Vassar-Robot-Competition-2018/teamD/Photos_Videos/Robot V1.jpg

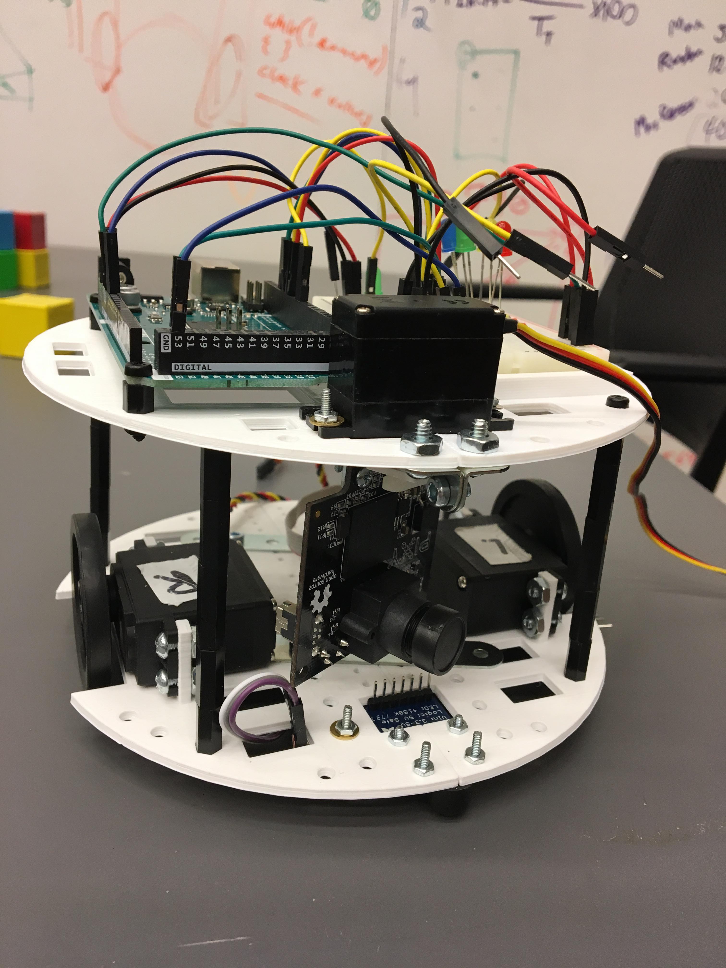
Photos_Videos/Robot V1.jpg
