Vassar-Robot-Competition-2018/teamD/Photos_Videos/Robot V2.jpg

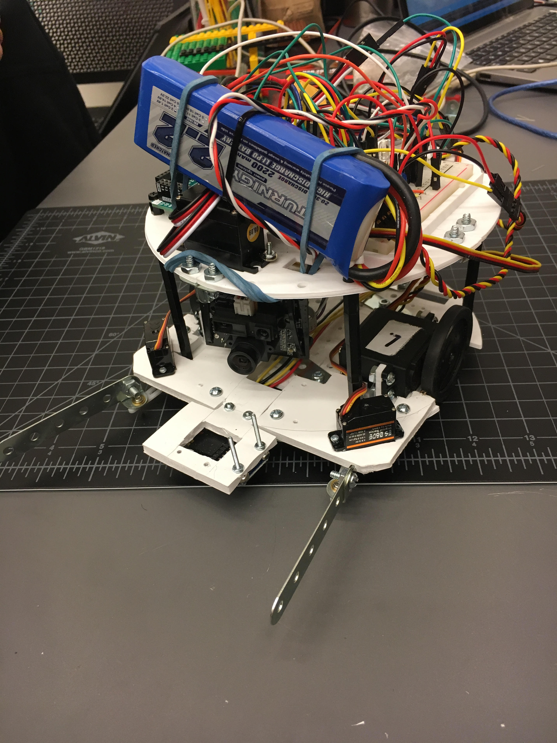
Photos_Videos/Robot V2.jpg
