Vassar-Robot-Competition-2018/teamD/Photos_Videos/Robot V4.JPG

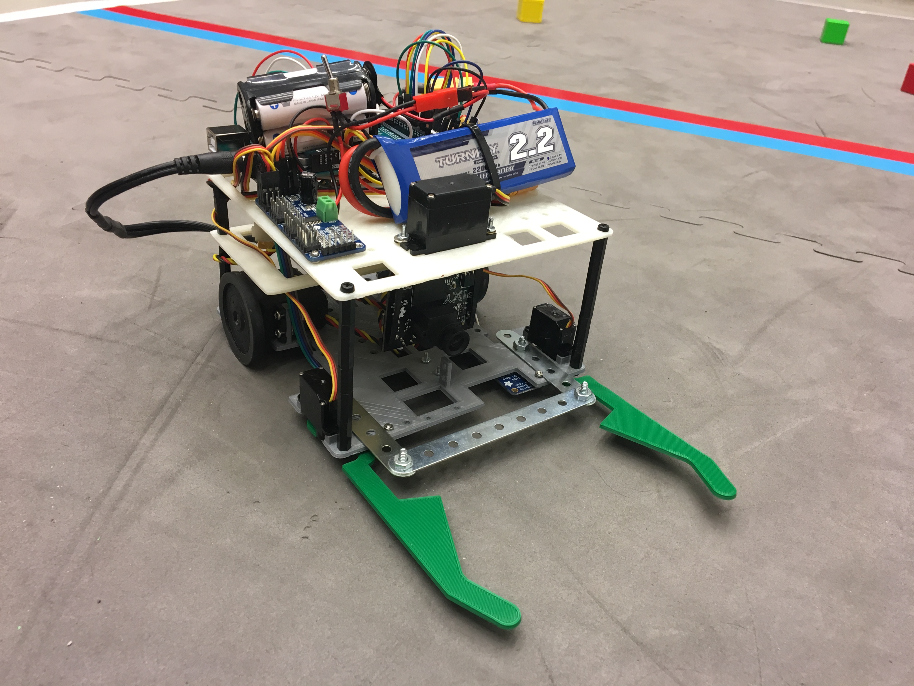
Photos_Videos/Robot V4.JPG
