Vassar-Robot-Competition-2018/teamD/Code/Final Code/Competition_Code/Competition_Code.ino

#include <SPI.h>
#include <Pixy.h>
#include <Wire.h>
#include <SoftwareWire.h>
#include <Adafruit_PWMServoDriver.h>
#include "Adafruit_TCS34725softi2c.h"
#include <Adafruit_VL6180X.h>

Pixy pixy;                // main Pixy object

#define WHITE  33         // white LED
#define RED_F 23          // right red LED 
#define YELLOW_F  27      // right yellow LED
#define GREEN_F  25       // right green LED
#define BLUE_F  29        // right blue LED
#define RED_B  37         // left red LED
#define YELLOW_B  41      // left yellow LED
#define GREEN_B  39       // left green LED
#define BLUE_B  43        // left blue LED
#define SDApinL  3        // SDA for left color sensor
#define SCLpinL  2        // SCL for left color sensor
#define SDApinR  5        // SDA for right color sensor
#define SCLpinR  4        // SCL for right color sensor
#define L_ARM  0          // left arm servo
#define R_ARM  1          // right arm servo
#define PAN_SERVO  2      // camera panning servo
#define L_WHEEL  4        // left wheel servo
#define R_WHEEL  5        // right wheel servo
#define PAN_MIN  240      // 250 (-100 mapped) far LEFT; 350 (0 mapped) is STRAIGHT FWD
#define PAN_MAX  455      // 450 (100 mapped) far RIGHT 
#define L_ARM_MIN  410    // 350 is OPEN (0 mapped)
#define L_ARM_MAX  435    // 375 is CLOSED (100 mapped)
#define R_ARM_MIN  320    // 328 is CLOSED (100 mapped)
#define R_ARM_MAX  350    // 355 is OPEN (0 mapped)
#define L_WHEEL_MIN  220  // 238 (100 mapped) full FORWARD; 360 is STOPPED (0 mapped)
#define L_WHEEL_MAX  500  // 482 (-100 mapped) full REVERSE;
#define R_WHEEL_MIN  220  // 238 (-100 mapped) full REVERSE; 360 is STOPPED (0 mapped)  230
#define R_WHEEL_MAX  500  // 482 (100 mapped) full FORWARD,                             490


//Declares constants

const int camSP = 160,     // pixy cam setpoint for pan PID
          servoSP = 0,
          camInterval = 20,
          wheelInterval = 20,
          scanInterval = 20,
          blockInterval = 20,
//          releaseInterval = 2000,
//          backupInterval = 1000,
//          turnInterval = 1000,
          TOFinterval = 50,
          colorInterval = 20;

unsigned long current, lastScanUpdate, lastCamUpdate, lastWheelUpdate, lastBlockUpdate, lastTOFupdate, lastColorUpdate, lastHeadingUpdate, tempTimer;

double trackTimeChange, trackError, trackPrevErr, trackdErr, servoAdj;
double followTimeChange, followError, followPrevErr, followdErr, wheelAdj;
double TOF_distance, TOFdist, raw_dist, prev_dist, temp_dist;

float trackKp = 0.08,   // 0.08 works well
      trackKd = 0.08,   // 0.08 works well
      followKp = 0.6,   // 0.7 works well
      followKd = 0.08;  // 0.08

int LC_gray, LR_gray, LG_gray, LB_gray,
    RC_gray, RR_gray, RG_gray, RB_gray,

    j, maxJ, prod, maxProd,
    maxSig = 6,
    max_X = camSP,
    maxWidth, maxHeight,

    quadrant = 0,
    homeQuad = 5,
    tempQuad = 0,
    prevQuad, quadL, quadR, oldQuad,

    Home = 5,
    Neutral_1 = 1,
    Enemy = 2,
    Neutral_2 = 3,

    captureB, captureQ, releaseQ,

    servoPos = 0,
    increment = 10,
    servoMin = -100,
    servoMax = 100,
    speedL = 0.0,
    speedR = 0.0,
    minSpeed = -100,
    maxSpeed = 100,
    baseSpeedL = 52,
    baseSpeedR = 47,
    highSpeedL = 77,
    highSpeedR = 71,
    differentialSpeed = 100,
    L_wheel,
    R_wheel,
    Status = 0;

/* initialize L and R color sensors with specific integration time, gain values and custom SDA / SCL pin */
Adafruit_TCS34725softi2c tcsL = Adafruit_TCS34725softi2c(TCS34725_INTEGRATIONTIME_2_4MS, TCS34725_GAIN_1X, SDApinL, SCLpinL);
Adafruit_TCS34725softi2c tcsR = Adafruit_TCS34725softi2c(TCS34725_INTEGRATIONTIME_2_4MS, TCS34725_GAIN_1X, SDApinR, SCLpinR);

/* initialize servo driver */
Adafruit_PWMServoDriver pwm = Adafruit_PWMServoDriver();

/* initialize time of flight (distance) sensor */
Adafruit_VL6180X vl = Adafruit_VL6180X(); // low range TOF sensor
