Vassar-Robot-Competition-2018/teamD/Code/Milestone_9/Milestone_9.20/Functions.ino

// Functions

void ColorSensorL() { // checks floor color sensor (up to 20 times per second)
  //uint16_t clear, red, green, blue;
  int clear, red, green, blue;

  tcsL.setInterrupt(false);      // turn on LED
  tcsL.getRawData(&red, &green, &blue, &clear);
  tcsL.setInterrupt(true);  // turn off LED

  Serial.print("Left: C = "); Serial.print(clear);
  Serial.print("; R = "); Serial.print(red);
  Serial.print("; G = "); Serial.print(green);
  Serial.print("; B = "); Serial.print(blue);

  if (clear == 0) {
    tcsL.begin();  // initializes left color sensor
    Serial.print("RESET");
  }

  if (LC_gray == 0) {
    L_ColorCalibration(clear, red, green, blue);
  }
  else {
    WhiteCheck(clear, LC_gray);
    QuadL(red, green, blue);
  }
}


void ColorSensorR() { // checks floor color sensor (up to 20 times per second)
  //uint16_t clear, red, green, blue;
  int clear, red, green, blue;

  tcsR.setInterrupt(false);      // turn on LED
  //delay(60);  // takes 50ms to read
  tcsR.getRawData(&red, &green, &blue, &clear);
  tcsR.setInterrupt(true);  // turn off LED

  Serial.print("     Right: C = "); Serial.print(clear);
  Serial.print("; R = "); Serial.print(red);
  Serial.print("; G = "); Serial.print(green);
  Serial.print("; B = "); Serial.println(blue);

  if (clear == 0) {
    tcsR.begin();  // initializes left color sensor
    Serial.print("RESET");
  }

  if (RC_gray == 0) {
    R_ColorCalibration(clear, red, green, blue);
  }
  else {
    WhiteCheck(clear, RC_gray);
    QuadR(red, green, blue);
  }
}


void ColorSensors() { // checks floor color sensor (up to 20 times per second)
  ColorSensorL();
  ColorSensorR();
  Quadrant();
}


void SetHome() { // sets home quadrant
  if ((Home == 5) && (quadrant != 0)) {
    Home = quadrant;
    Cap_Rel_Table();
    Status = 1;
  }
}


void Quadrant() {
  if (quadL != quadR) {
    Align();
  }
  quadrant = quadL;
  SetHome();
  QuadrantLED();
  HomeLED();
}


void QuadL(int r, int g, int b) {
  if (r > (g + b))  //red
    quadL = 1;

  else if ((r + g) > (4 * b))  //yellow
    quadL = 2;

  else if ((3 * g) > ((r + b) * 2))  //green
    quadL = 3;

  else if (b > (2 * r))  //blue
    quadL = 4;

  if (quadL != tempQuadL) {
    prevQuadL = tempQuadL;
    tempQuadL = quadL;
    newQuad = 1;
  }
}


void QuadR(int r, int g, int b) {
  if (r > (g + b))  //red
    quadR = 1;

  else if ((r + g) > (4 * b))  //yellow
    quadR = 2;

  else if ((3 * g) > ((r + b) * 2))  //green
    quadR = 3;

  else if (b > (2 * r))  //blue
    quadR = 4;

  if (quadR != tempQuadR) {
    prevQuadR = tempQuadR;
    tempQuadR = quadR;
    newQuad = 2;
  }
}


void Align() {
  if (newQuad == 1) {
    MotorUpdate(0, baseSpeedR);
  }
  else if (newQuad == 2) {
    MotorUpdate(baseSpeedL, 0);
  }
}

void L_ColorCalibration(int c, int r, int g, int b) {
  LC_gray = c;
  LR_gray = r;
  LG_gray = g;
  LB_gray = b;

  Serial.print("Left Color calibration complete");
}


void R_ColorCalibration(int c, int r, int g, int b) {
  RC_gray = c;
  RR_gray = r;
  RG_gray = g;
  RB_gray = b;

  Serial.print("Right Color calibration complete");
}


void WhiteCheck(int c, int C_gray) {
  if (c > (4 * C_gray)) {  // maybe 4*Cgray when white tape is used
    Serial.println("White Detected");
    digitalWrite(WHITE, HIGH);    // LED

    DriveReverse();
    delay(1000);

    RightTurn();
    delay(1000);
  }
  else {
    digitalWrite(WHITE, LOW);    // LED
  }
}


void HomeLED() {
  if (Home == 1) {
    //Serial.println("Red");
    digitalWrite(RED_F, HIGH);    // LED
    digitalWrite(YELLOW_F, LOW);    // LED
    digitalWrite(GREEN_F, LOW);    // LED
    digitalWrite(BLUE_F, LOW);    // LED
  }

  else if (Home == 2) {
    //Serial.println("Yellow");
    digitalWrite(RED_F, LOW);    // LED
    digitalWrite(YELLOW_F, HIGH);    // LED
    digitalWrite(GREEN_F, LOW);    // LED
    digitalWrite(BLUE_F, LOW);    // LED
  }

  else if (Home == 3) {
    //Serial.println("Green");
    digitalWrite(RED_F, LOW);    // LED
    digitalWrite(YELLOW_F, LOW);    // LED
    digitalWrite(GREEN_F, HIGH);    // LED
    digitalWrite(BLUE_F, LOW);    // LED
  }

  else if (Home == 4) {
    //Serial.println("Blue");
    digitalWrite(RED_F, LOW);    // LED
    digitalWrite(YELLOW_F, LOW);    // LED
    digitalWrite(GREEN_F, LOW);    // LED
    digitalWrite(BLUE_F, HIGH);    // LED
  }

  else {
    digitalWrite(RED_F, LOW);    // LED
    digitalWrite(YELLOW_F, LOW);    // LED
    digitalWrite(GREEN_F, LOW);    // LED
    digitalWrite(BLUE_F, LOW);    // LED
  }
}


void QuadrantLED() {
  if (quadrant == 1) {
    //Serial.println("Red");
    digitalWrite(RED_B, HIGH);    // LED
    digitalWrite(YELLOW_B, LOW);    // LED
    digitalWrite(GREEN_B, LOW);    // LED
    digitalWrite(BLUE_B, LOW);    // LED
  }

  else if (quadrant == 2) {
    //Serial.println("Yellow");
    digitalWrite(RED_B, LOW);    // LED
    digitalWrite(YELLOW_B, HIGH);    // LED
    digitalWrite(GREEN_B, LOW);    // LED
    digitalWrite(BLUE_B, LOW);    // LED
  }

  else if (quadrant == 3) {
    //Serial.println("Green");
    digitalWrite(RED_B, LOW);    // LED
    digitalWrite(YELLOW_B, LOW);    // LED
    digitalWrite(GREEN_B, HIGH);    // LED
    digitalWrite(BLUE_B, LOW);    // LED
  }

  else if (quadrant == 4) {
    //Serial.println("Blue");
    digitalWrite(RED_B, LOW);    // LED
    digitalWrite(YELLOW_B, LOW);    // LED
    digitalWrite(GREEN_B, LOW);    // LED
    digitalWrite(BLUE_B, HIGH);    // LED
  }

  else {
    digitalWrite(RED_B, LOW);    // LED
    digitalWrite(YELLOW_B, LOW);    // LED
    digitalWrite(GREEN_B, LOW);    // LED
    digitalWrite(BLUE_B, LOW);    // LED
  }
}


void BlockColor () {
  if (maxSig == 1) {
    //Serial.println("Red");
    digitalWrite(RED_B, HIGH);    // LED
    digitalWrite(YELLOW_B, LOW);    // LED
    digitalWrite(GREEN_B, LOW);    // LED
    digitalWrite(BLUE_B, LOW);    // LED
  }

  else if (maxSig == 2) {
    //Serial.println("Yellow");
    digitalWrite(RED_B, LOW);    // LED
    digitalWrite(YELLOW_B, HIGH);    // LED
    digitalWrite(GREEN_B, LOW);    // LED
    digitalWrite(BLUE_B, LOW);    // LED
  }

  else if (maxSig == 3) {
    //Serial.println("Green");
    digitalWrite(RED_B, LOW);    // LED
    digitalWrite(YELLOW_B, LOW);    // LED
    digitalWrite(GREEN_B, HIGH);    // LED
    digitalWrite(BLUE_B, LOW);    // LED
  }

  else if (maxSig == 4) {
    //Serial.println("Blue");
    digitalWrite(RED_B, LOW);    // LED
    digitalWrite(YELLOW_B, LOW);    // LED
    digitalWrite(GREEN_B, LOW);    // LED
    digitalWrite(BLUE_B, HIGH);    // LED
  }
  else {
    digitalWrite(RED_B, LOW);    // LED
    digitalWrite(YELLOW_B, LOW);    // LED
    digitalWrite(GREEN_B, LOW);    // LED
    digitalWrite(BLUE_B, LOW);    // LED
  }
}


void DriveForward() {
  speedL = baseSpeedL;
  speedR = baseSpeedR;
  MotorUpdate(speedL, speedR);
}


void DriveReverse() {
  speedL = -baseSpeedL;
  speedR = -baseSpeedR;
  MotorUpdate(speedL, speedR);
}


void LeftTurn() {
  speedL = -baseSpeedL;
  speedR = baseSpeedR;
  MotorUpdate(speedL, speedR);
}


void RightTurn() {
  speedL = 50;
  speedR = -50;
  MotorUpdate(speedL, speedR);
}


void DriveStop() {
  speedL = 0;
  speedR = 0;
  MotorUpdate(speedL, speedR);
}


void Grab() {
  MotorUpdate(baseSpeedL, baseSpeedR);
  delay(500);
  UpdateArms(100, 100);
  delay(50);
  MotorUpdate(0, 0);
  delay(500);
  MotorUpdate(baseSpeedL, -baseSpeedR);
  delay(1000);
  MotorUpdate(0, 0);
  delay(100);

  //  digitalWrite(RED_R, HIGH);
  //  delay(1000);
  //  digitalWrite(RED_R, LOW);
}


void Release() {
  MotorUpdate(baseSpeedL, baseSpeedR);
  delay(3000);
  MotorUpdate(0, 0);
  delay(100);
  UpdateArms(0, 0);
  delay(50);
  MotorUpdate(-baseSpeedL, -baseSpeedR);
  delay(1000);
  MotorUpdate(-baseSpeedL, baseSpeedR);
  delay(1000);
  MotorUpdate(0, 0);
  delay(100);
  maxSig = 6;

  //  digitalWrite(BLUE_R, HIGH);
  //  delay(1000);
  //  digitalWrite(BLUE_R, LOW);
}


void MotorUpdate(double L, double R) {
  double servoL_speed = (L * (-0.9)) + 92;
  double servoR_speed = (R * 0.9 ) + 92;
  servoL.write(servoL_speed);
  servoR.write(servoR_speed);
}


void UpdatePan(double pos) {
  double pan_pulse = map(pos, -100, 100, PAN_MIN, PAN_MAX); // straight
  pwm.setPWM(PAN_SERVO, 0, pan_pulse);
  // delay(20);
}


void UpdateArms(int L, int R) {
  int l_arm_pulse = map(L, 0, 100, L_ARM_MIN, L_ARM_MAX); // 0 is open, 100 is closed
  int r_arm_pulse = map(R, 100, 0, R_ARM_MIN, R_ARM_MAX); // 0 is open, 100 is closed
  pwm.setPWM(L_ARM, 0, l_arm_pulse);
  pwm.setPWM(R_ARM, 0, r_arm_pulse);
}


void CheckBlocks() {
  // for (int k = 0; k < 10; k++) {
  static int i = 0;
  uint16_t blocks;
  char buf[32];

  maxJ = 0;
  maxSig = 6;
  max_X = camSP;
  max_Y = 0;
  maxWidth = 0;
  maxHeight = 0;

  if (Home != 5) {
    blocks = pixy.getBlocks();

    if (blocks) { //if a color sig is detected by pixy cam
      for (j = 0; j < blocks; j++) { //find the largest signature
        if ((pixy.blocks[j].height > 20) && (pixy.blocks[j].height < 150)) {
          if ((pixy.blocks[j].width > 20) && (pixy.blocks[j].width < 150)) {
            maxJ = j;
            maxSig = pixy.blocks[maxJ].signature;
            max_X = pixy.blocks[maxJ].x;
            max_Y = pixy.blocks[maxJ].y;
            maxHeight = pixy.blocks[maxJ].height;
            maxWidth = pixy.blocks[maxJ].width;
          }
        }
      }
      //    Serial.print("Block Position: ");
      //    Serial.print(max_X);
      //    Serial.print("     ");
      //    Serial.print("Block Width: ");
      //    Serial.print(maxWidth);
      //    Serial.print(" x ");
      //    Serial.println(maxWidth);
    }
  }
}


void Scan() {
  current = millis();
  if ((current - lastScanUpdate) > scanInterval) // time to update
  {
    lastScanUpdate = millis();
    servoPos += increment;
    UpdatePan(servoPos);
    //delay(20);

    //Serial.println(servoPos);
    if ((servoPos >= servoMax) || (servoPos <= servoMin)) // end of sweep
    {
      // reverse direction
      increment = -increment;
    }
  }
}


void Track()
{
  /*How long since we last calculated*/
  current = millis();
  trackTimeChange = (double)(current - trackPrevTime);
  trackError = camSP - max_X;
  if (trackTimeChange > 100) {
    trackErrSum = 0;
    trackdErr = 0;
  }
  else {
    /*Compute all the working error variables*/
    trackErrSum += (trackError * trackTimeChange);
    trackdErr = (trackError - trackPrevErr) / trackTimeChange;
  }
  /*Compute PID Output*/
  servoAdj = trackKp * trackError + trackKi * trackErrSum + trackKd * trackdErr;

  /*Remember some variables for next time*/
  trackPrevErr = trackError;
  trackPrevTime = current;

  servoPos = (int)constrain(servoPos + servoAdj, servoMin, servoMax);

  current = millis();
  if ((current - lastCamUpdate) > camInterval) // time to update
  {
    lastCamUpdate = millis();
    UpdatePan(servoPos);
  }
}


void Follow()
{
  /*How long since we last calculated*/
  current = millis();
  followTimeChange = (double)(current - followPrevTime);
  followError = servoSP - servoPos;
  if (followTimeChange > 100) {
    followErrSum = 0;
    followdErr = 0;
  }
  else {
    /*Compute all the working error variables*/
    followErrSum += (followError * followTimeChange);
    followdErr = (followError - followPrevErr) / followTimeChange;
  }
  /*Compute PID Output*/
  wheelAdj = followKp * followError + followKi * followErrSum + followKd * followdErr;

  /*Remember some variables for next time*/
  followPrevErr = followError;
  followPrevTime = current;
  //if(wheelAdj > 0) {
  //    speedL = (int)constrain(baseSpeedL + 0.5*wheelAdj, minSpeed, maxSpeed);
  //  speedR = (int)constrain(baseSpeedR - wheelAdj, minSpeed, maxSpeed);
  //}
  //else if(wheelAdj < 0) {
  //    speedL = (int)constrain(baseSpeedL + wheelAdj, minSpeed, maxSpeed);
  //  speedR = (int)constrain(baseSpeedR - 0.5*wheelAdj, minSpeed, maxSpeed);
  //}
  speedL = (int)constrain(baseSpeedL + wheelAdj, minSpeed, maxSpeed);
  speedR = (int)constrain(baseSpeedR - wheelAdj, minSpeed, maxSpeed);

  //    Serial.print("Follow Error: ");
  //    Serial.println(followError);

  Serial.print("L speed: ");
  Serial.print(speedL);
  Serial.print(",    R speed: ");
  Serial.println(speedR);

  current = millis();
  if ((current - lastWheelUpdate) > wheelInterval) // time to update
  {
    lastWheelUpdate = millis();
    MotorUpdate(speedL, speedR);
  }
}

boolean Captured() {
  if (maxSig != 6) {
    //   if (((maxHeight > 80)  && (maxHeight < 125)) && ((maxWidth > 105)  && (maxWidth <  150))) {
    if ((maxHeight > 80)  && (maxWidth > 105)) {
      return true;
    }
    else return false;
  }
  else return false;
}
