Vassar-Robot-Competition-2018/teamD/Code/Final Code/Competition_Code/Capture-Release_Table.ino

// set capture-release variables based on Home

void Cap_Rel_Table() {
  Neutral_1 += Home;
  if (Neutral_1 > 4) {
    Neutral_1 -= 4;
  }
  else Enemy += Home;
  if (Enemy > 4) {
    Enemy -= 4;
  }
  Neutral_2 += Home;
  if (Neutral_2 > 4) {
    Neutral_2 -= 4;
  }
}
