Vassar-Robot-Competition-2018/teamD/(commit log)

2018-02-03 Pixy Blocks with LEDs
    This program uses the Pixy Cam to determine the largest signature block in view, prints the color, size and coordinates of that signature to the serial monitor, and lights up the corresponding colored LED
2018-02-03 Pixy Cam Servo
    This program is for a servo attached to the Pixy Cam, causing the camera to sweep back and forth in search of colored blocks.
2018-02-03 Milestone 2
    This program causes the robot to drive forward until the downward-pointing QRE1113 line sensor detects a white surface. This causes the robot to drive backwards for 1 second, stop for 1 second, and then resume going forward. An LED also lights up when a white surface is detected.
2018-02-03 Pixy Cam Color Search
    This program uses the Pixy Cam to determine the largest signature block in view, prints the color, size and coordinates of that signature to the serial monitor, and lights up the corresponding colored LED. If a color signature is not detected, a servo sweeps the pixy cam back and forth until a color signature is detected.
2018-02-03 Pixy Cam searches for and tracks colored blocks
    The Pixy Cam sweeps back and forth searching for a signature block. Once a signature block is detected, the Pixy Cam uses a servo to continue tracking the block.
2018-02-03 Servo Sweep for Pixy Cam
2018-02-03 Pixy Cam searches for colored blocks
    This program uses the Pixy Cam to determine the largest signature block in view, prints the color, size and coordinates of that signature to the serial monitor, and lights up the corresponding colored LED. If a color signature is not detected, a servo causes the pixy to sweep back and forth until a color signature is detected.
2018-02-09 Pin Information
    Added pin information text file
2018-02-09 Converts motor speeds to servo write values
2018-02-09 Milestone 2 with motor update
2018-02-09 Updated servo pins
2018-02-10 Uses PID to track blocks with Pixy Servo
2018-02-10 Milestone 3 incorporating PID
2018-02-10 Uses PID on pixy cam and wheels
    Uses PID to track blocks with pixy/servo. Uses PID to steer wheels toward blocks
2018-02-16 Using early PID to steer toward blocks
2018-03-05 MiniBot - Milestone 7
    Uses two color sensors and updated IR code
2018-03-06 IR Update
    [IR Distance Values.xlsx]
2018-03-27 3/27/18
    Adds dual color sensors, timing for PID, servo controller
2018-03-30 Works but without claws
2018-04-17 Uses magnetometer and differential base speed
    Uses magnetometer data to determine course heading. Incorporates differential base speed in both FollowBlock and UpdateHeading PID functions.
2018-05-11 Grabs blocks well. May need status 3 turns and release turn adjusted, and R wheel speed adjusted to match the left
