Vassar-Robot-Competition-2018/teamD/Photos_Videos/Robot V5 Above.JPG

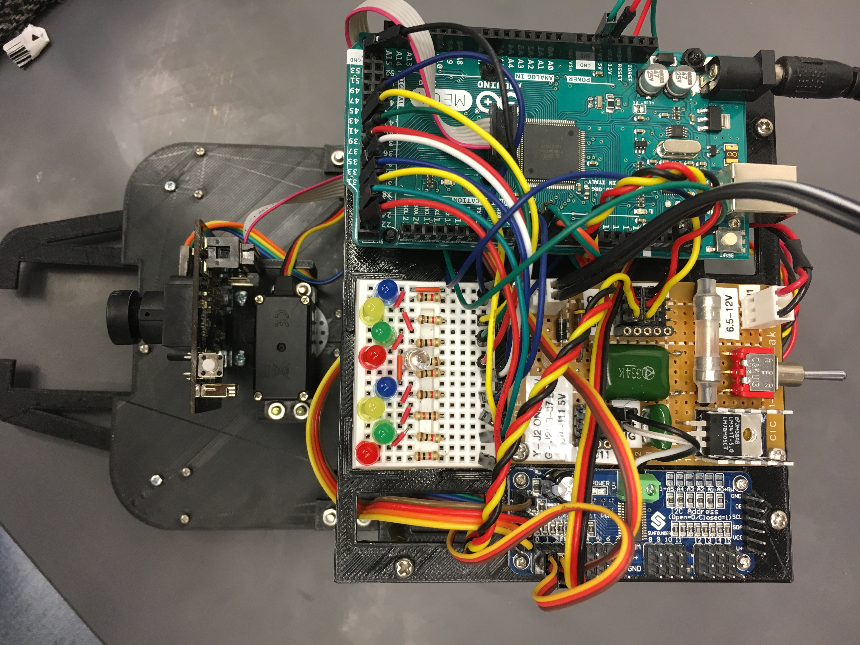
Photos_Videos/Robot V5 Above.JPG
